lluisgl7/tea-timer/schematic/png/tea_timer_bb.png

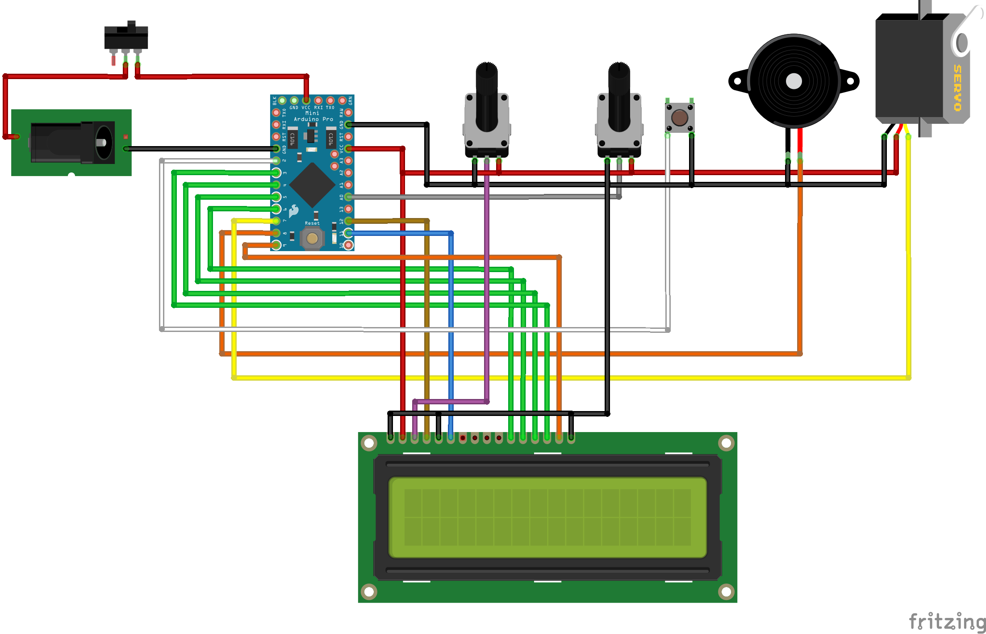
schematic/png/tea_timer_bb.png
