lluisgl7/tea-timer/schematic/png/tea_timer_schem.png

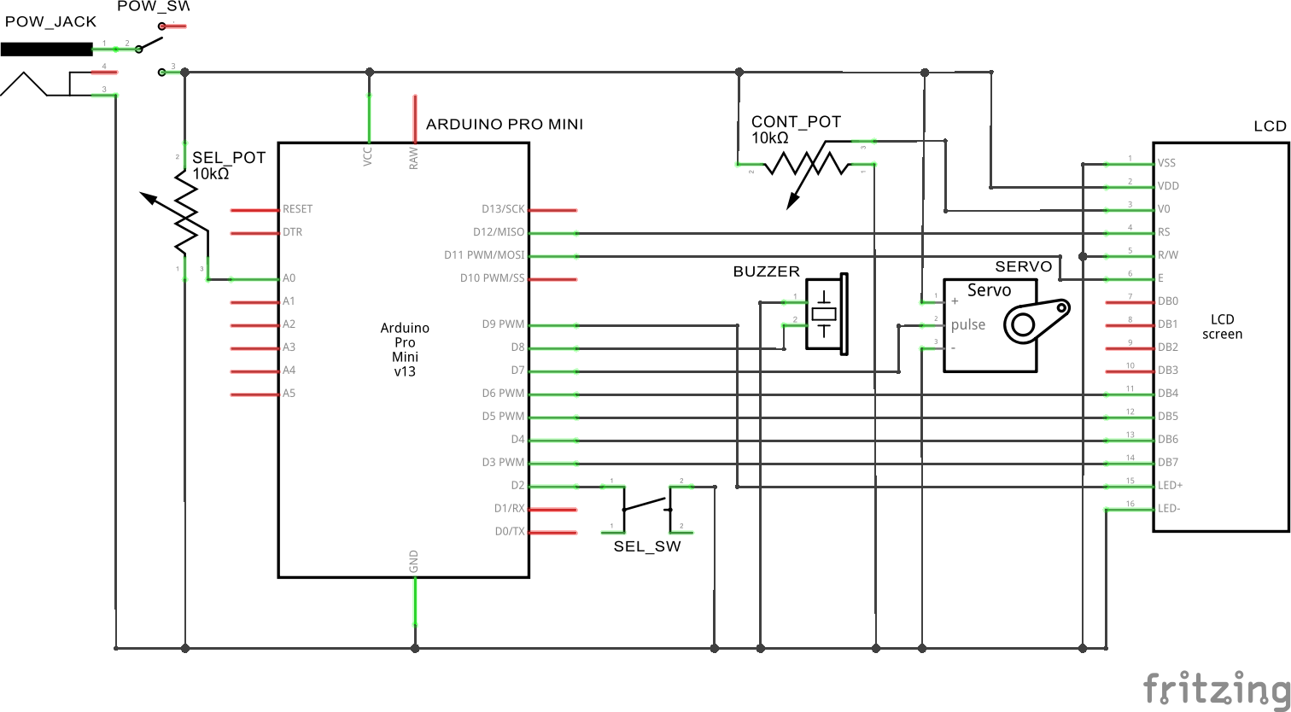
schematic/png/tea_timer_schem.png
