lluisgl7/tea-timer/3d-parts/stl/tea_timer_main_supports.stl

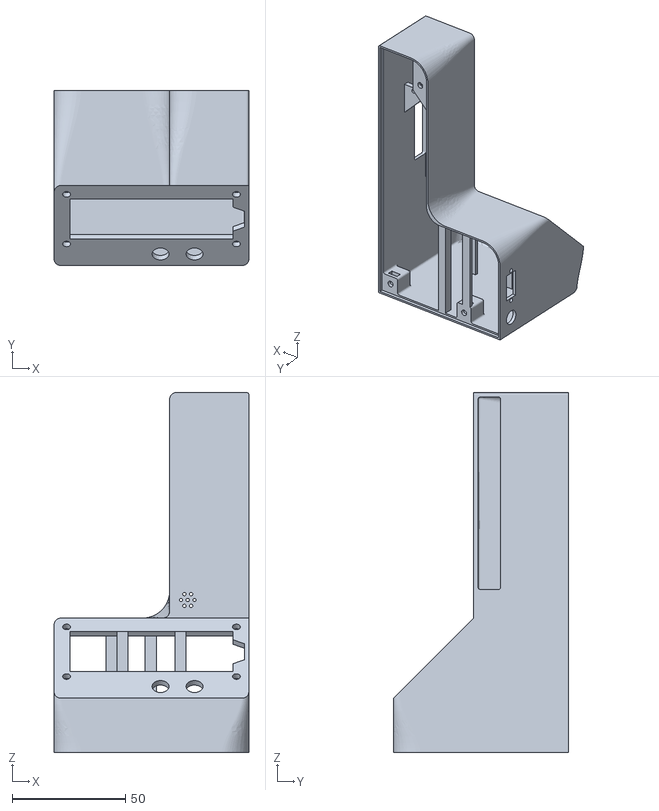
[picture p5: CAD file, 2015-09-18]
3d-parts/stl/tea_timer_main_supports.stl
86.0 x 77.4 x 159.0
