lluisgl7/tea-timer/3d-parts/freecad/arm.FCStd

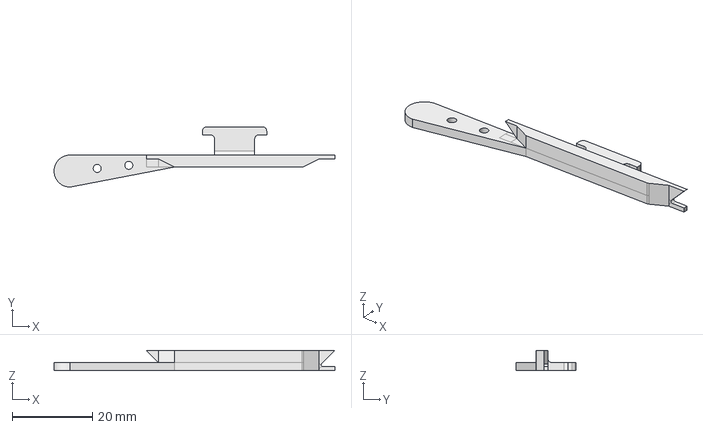
[picture p7: CAD file, 2015-09-18]
3d-parts/freecad/arm.FCStd
70.0 x 15.0 x 5.00 mm
