lluisgl7/tea-timer/3d-parts/stl/tea_timer_lid.stl

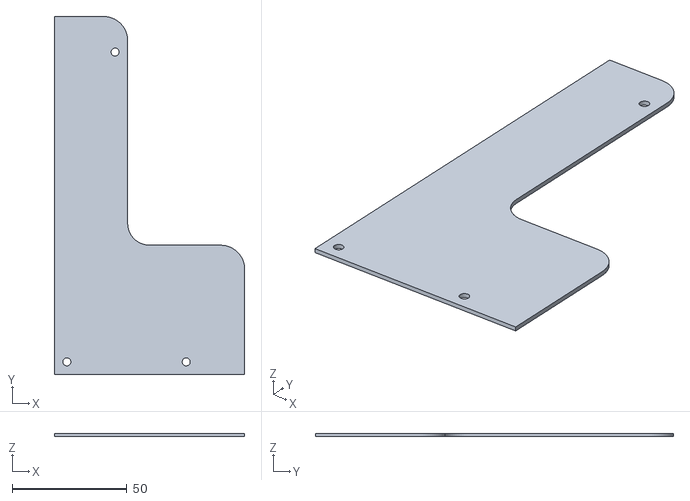
[picture p8: CAD file, 2015-09-18]
3d-parts/stl/tea_timer_lid.stl
83.0 x 156.0 x 1.50
