lluisgl7/tea-timer/(list of files, cad)

Other CAD files:
3d-parts/freecad/lid.FCStd
3d-parts/stl/tea_timer_arm.stl
