lluisgl7/tea-timer/schematic/pdf/tea_timer_bb.pdf

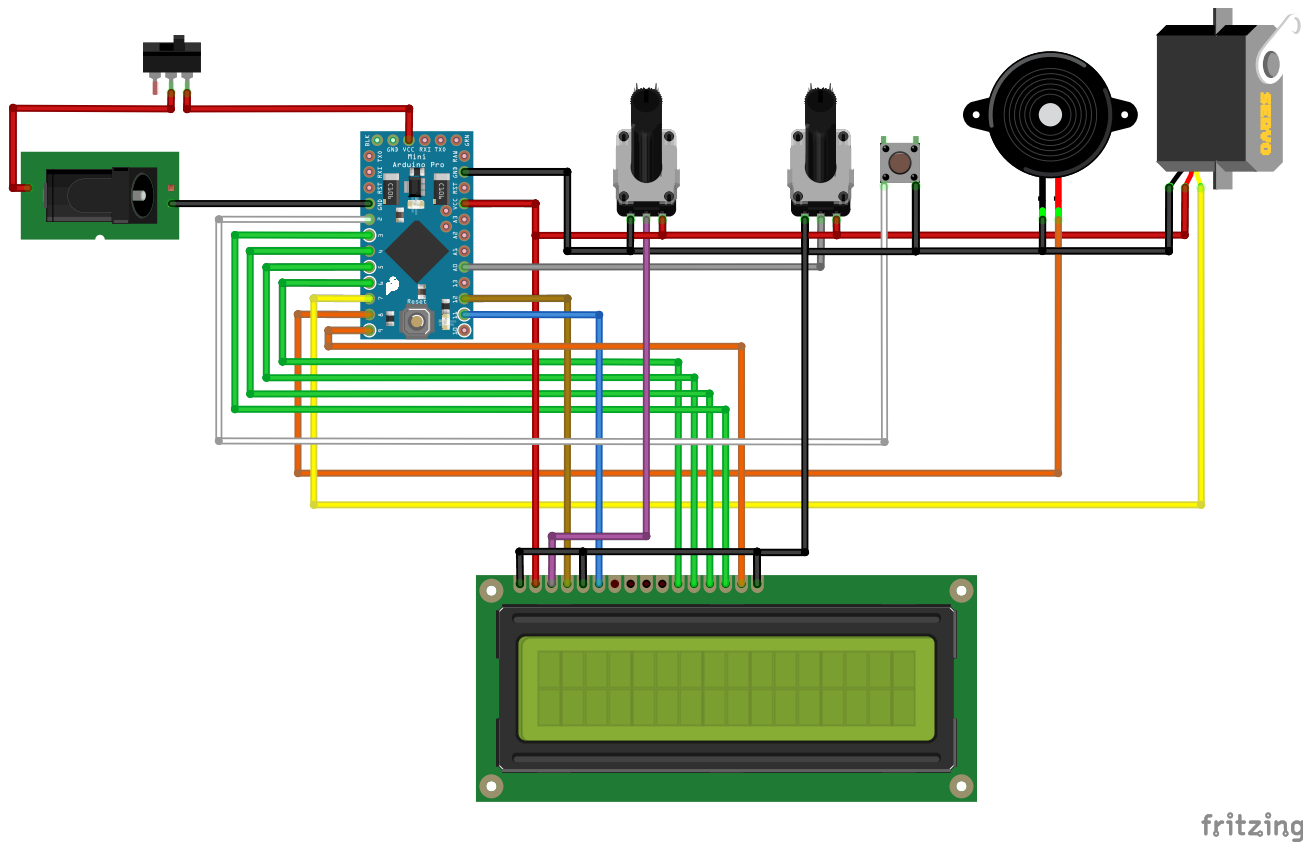
[picture p9: page 1]
