lluisgl7/tea-timer/schematic/pdf/tea_timer_schem.pdf

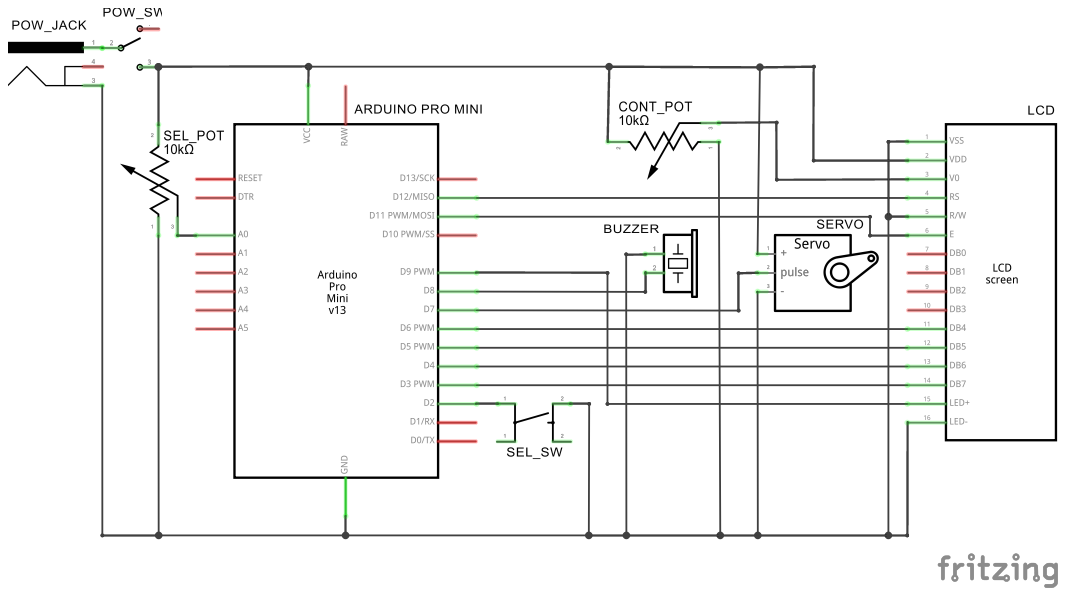
[picture p10: page 1]
