lluisgl7/tea-timer/(list of files, drawings)

Other design files:
schematic/fritzing/tea_timer.fzz
