lluisgl7/tea-timer/(commit log)

2015-10-23 Added schematic images
2015-10-23 Schematic pdf and png folders
